gusocosta/ESP32_MP3_Player/bitmaps.h

#pragma once
#include <Arduino.h>

// 'file', 8x8px
const unsigned char spr_file [] PROGMEM = {
	0x3e, 0x3e, 0x3e, 0x3c, 0x3c, 0x3c, 0x3c, 0x00
};
// 'back', 16x16px
const unsigned char spr_back [] PROGMEM = {
	0x00, 0x80, 0x80, 0xc0, 0xc0, 0xe0, 0xe0, 0xf0, 0xf0, 0xf8, 0xf8, 0xc0, 0xe0, 0xf0, 0xf8, 0x00, 
	0x00, 0x01, 0x01, 0x03, 0x03, 0x07, 0x07, 0x0f, 0x0f, 0x1f, 0x1f, 0x03, 0x07, 0x0f, 0x1f, 0x00
};
// 'forw', 16x16px
const unsigned char spr_forw [] PROGMEM = {
	0x00, 0xf8, 0xf0, 0xe0, 0xc0, 0xf8, 0xf8, 0xf0, 0xf0, 0xe0, 0xe0, 0xc0, 0xc0, 0x80, 0x80, 0x00, 
	0x00, 0x1f, 0x0f, 0x07, 0x03, 0x1f, 0x1f, 0x0f, 0x0f, 0x07, 0x07, 0x03, 0x03, 0x01, 0x01, 0x00
};
// 'pause', 16x16px
const unsigned char spr_pause [] PROGMEM = {
	0x00, 0x00, 0x00, 0xfe, 0xfe, 0xfe, 0xfe, 0x00, 0x00, 0xfe, 0xfe, 0xfe, 0xfe, 0x00, 0x00, 0x00, 
	0x00, 0x00, 0x00, 0x7f, 0x7f, 0x7f, 0x7f, 0x00, 0x00, 0x7f, 0x7f, 0x7f, 0x7f, 0x00, 0x00, 0x00
};
// 'play', 16x16px
const unsigned char spr_play [] PROGMEM = {
	0xf8, 0xfc, 0xfc, 0xfc, 0xf8, 0xf8, 0xf0, 0xf0, 0xe0, 0xe0, 0xc0, 0xc0, 0x80, 0x80, 0x00, 0x00, 
	0x1f, 0x3f, 0x3f, 0x3f, 0x1f, 0x1f, 0x0f, 0x0f, 0x07, 0x07, 0x03, 0x03, 0x01, 0x01, 0x00, 0x00
};

// 'sel', 8x8px
const unsigned char spr_sel [] PROGMEM = {
	0x00, 0x00, 0xfe, 0xfe, 0x7c, 0x38, 0x10, 0x00
};
