gusocosta/ESP32_MP3_Player/(commit log)

2026-07-16 Schematics V1
2026-07-16 Del Schematics
2026-07-16 Update Schematics V1
2026-07-17 Update Vin on ESP32 to the 5V pin
2026-07-18 update Schematics
